TheAdityaKedia/Out-The-Door/enclosure/doorstep-back/REQUIREMENTS.md

# Requirements

Doorstep-back follows every rule in [Doorstep's REQUIREMENTS.md](../doorstep/REQUIREMENTS.md) that still applies (board lock, drum mount, USB opening, hole sizing, no supports on mating faces). Rules learned from Doorstep-back prints go below.
