TheAdityaKedia/Out-The-Door/enclosure/doorstep-back/renders/body-1.png

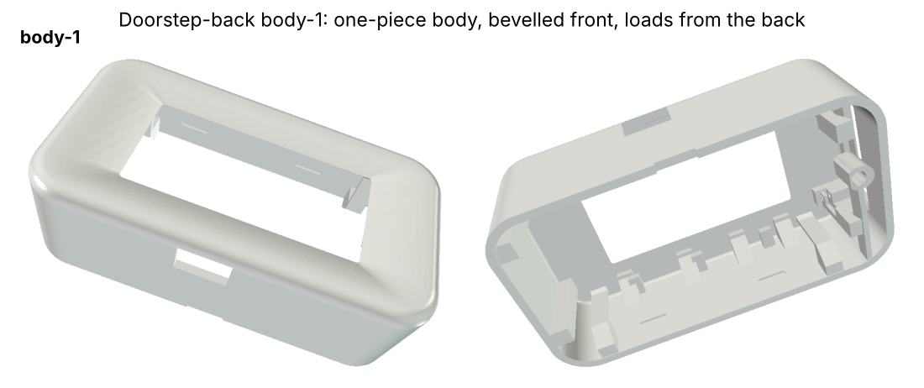
enclosure/doorstep-back/renders/body-1.png
