TheAdityaKedia/Out-The-Door/enclosure/doorstep-back/renders/cap-1.png

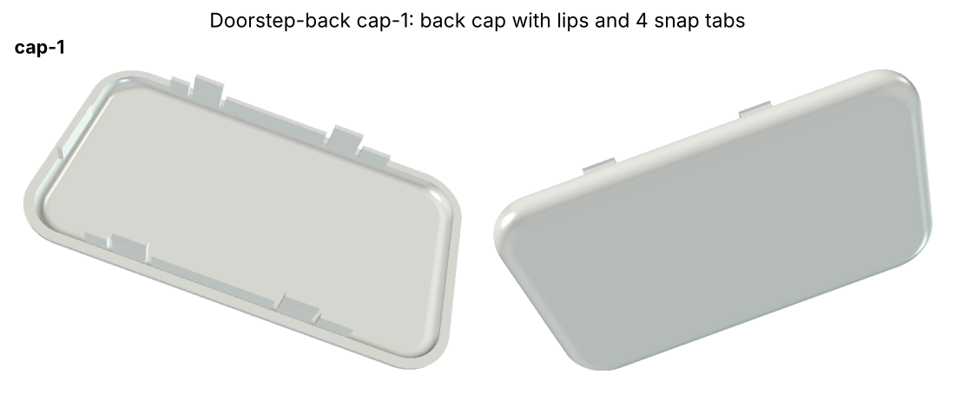
enclosure/doorstep-back/renders/cap-1.png
