TheAdityaKedia/Out-The-Door/enclosure/doorstep-back/renders/drum-1.png

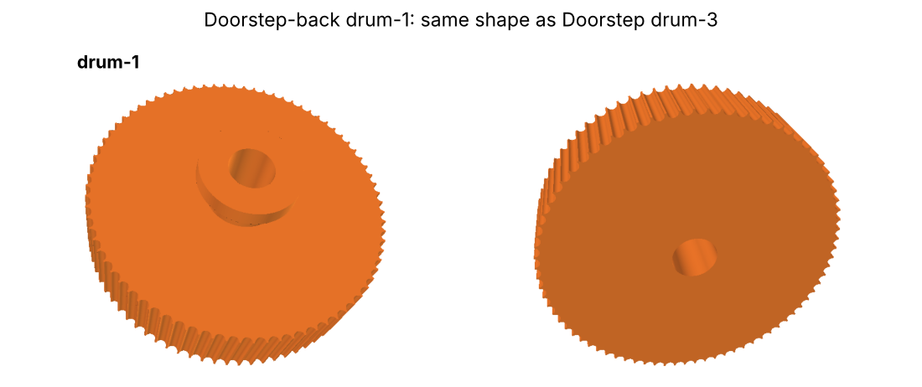
enclosure/doorstep-back/renders/drum-1.png
