TheAdityaKedia/Out-The-Door/enclosure/doorstep-back/renders/pin-1.png

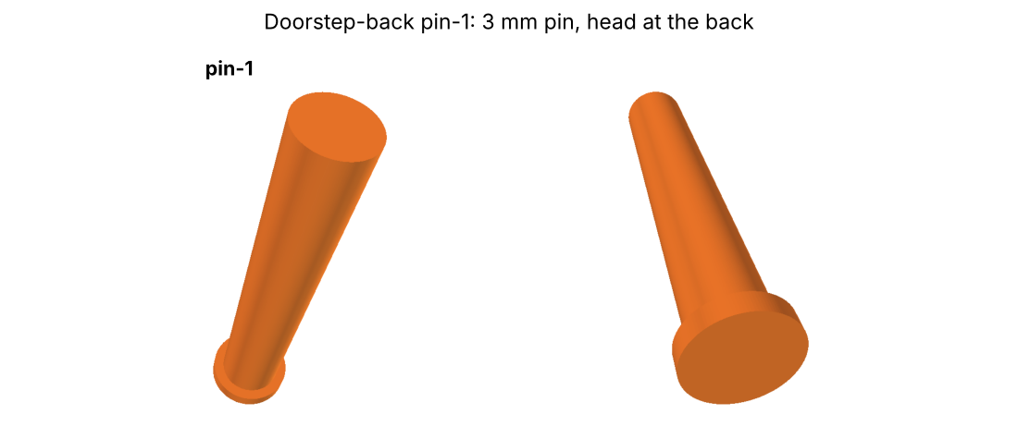
enclosure/doorstep-back/renders/pin-1.png
