TheAdityaKedia/Out-The-Door/enclosure/doorstep/docs/board_lock_preview.png

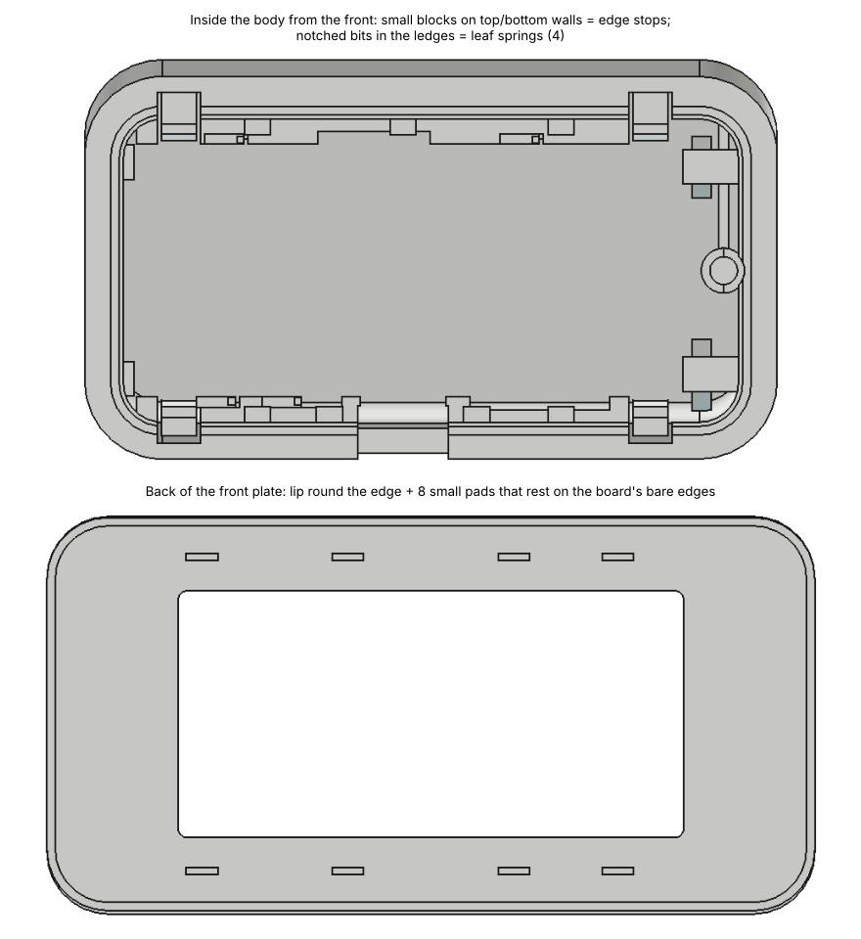
enclosure/doorstep/docs/board_lock_preview.png
