TheAdityaKedia/Out-The-Door/enclosure/doorstep/docs/board_spring_idea.png

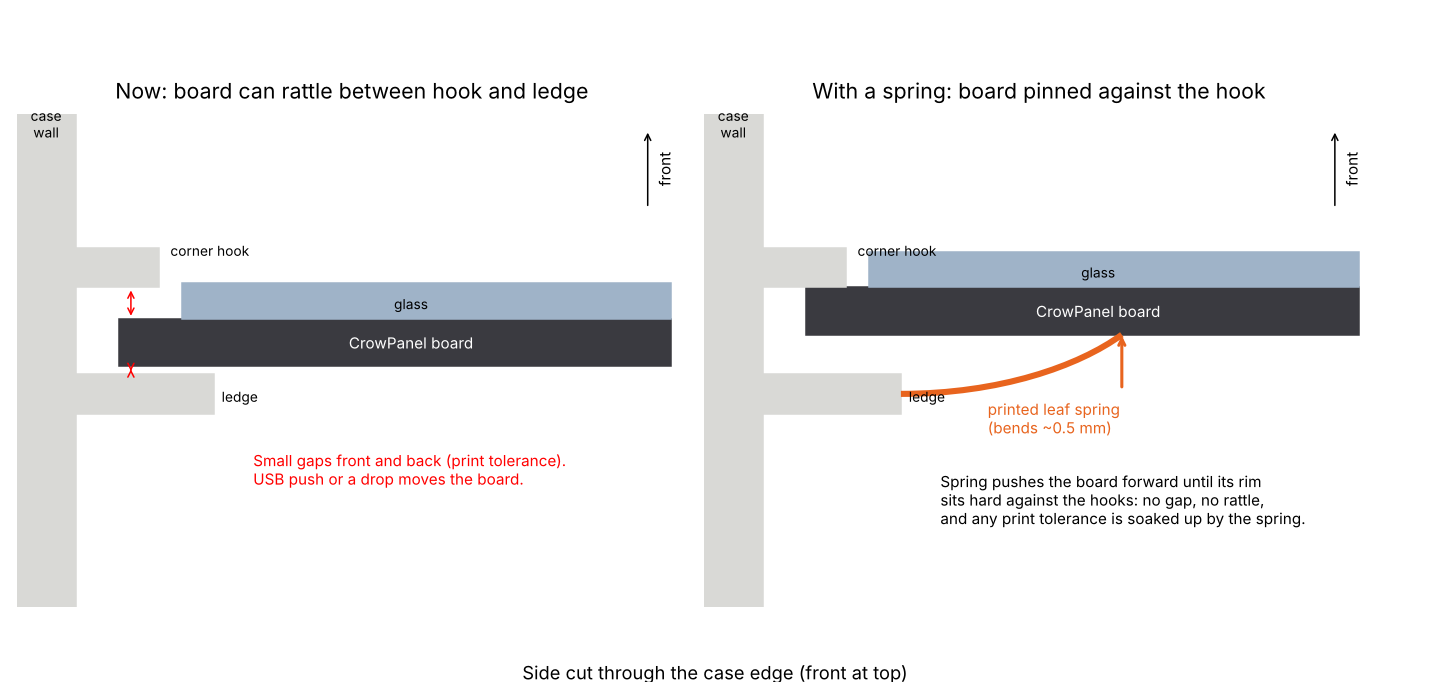
enclosure/doorstep/docs/board_spring_idea.png
