TheAdityaKedia/Out-The-Door/enclosure/doorstep/docs/drum_contact_slice.png

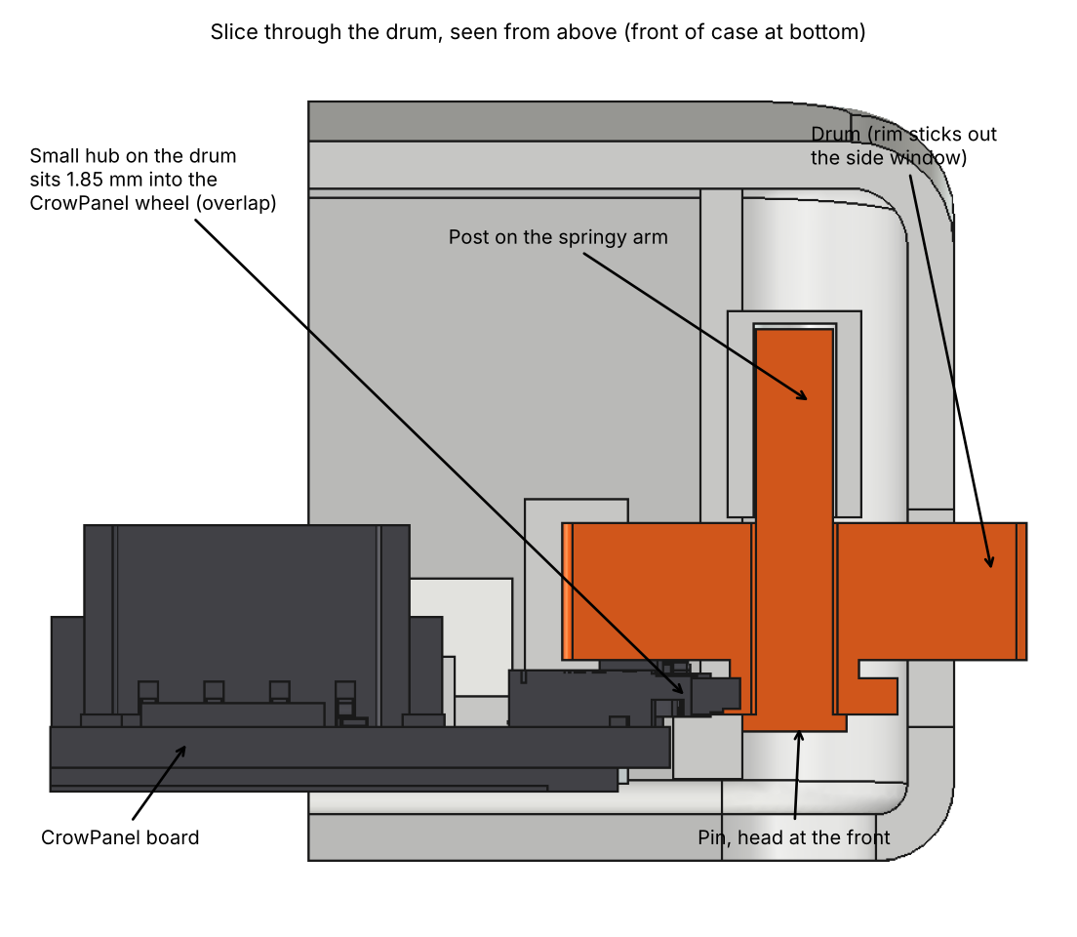
enclosure/doorstep/docs/drum_contact_slice.png
