TheAdityaKedia/Out-The-Door/enclosure/doorstep/docs/lip_buttons_preview.png

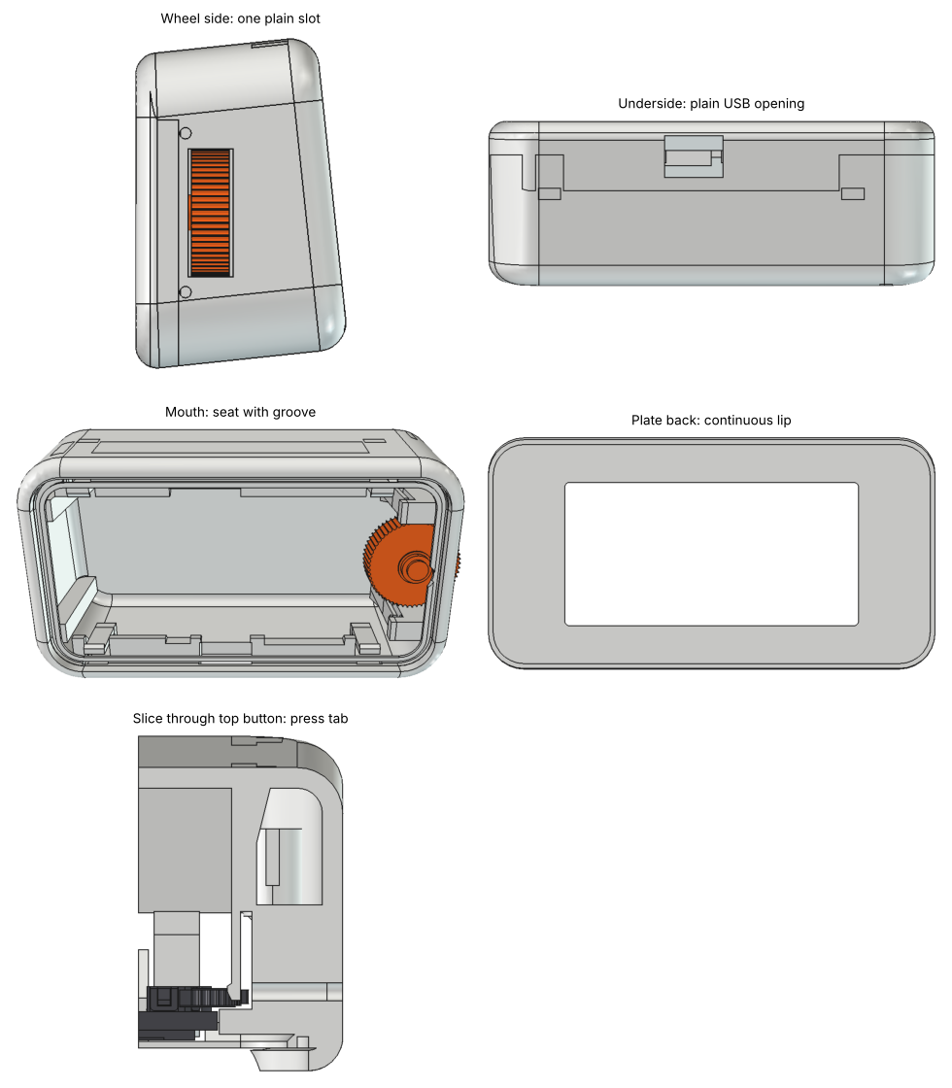
enclosure/doorstep/docs/lip_buttons_preview.png
