TheAdityaKedia/Out-The-Door/enclosure/doorstep/docs/wheel_end_no_drum.png

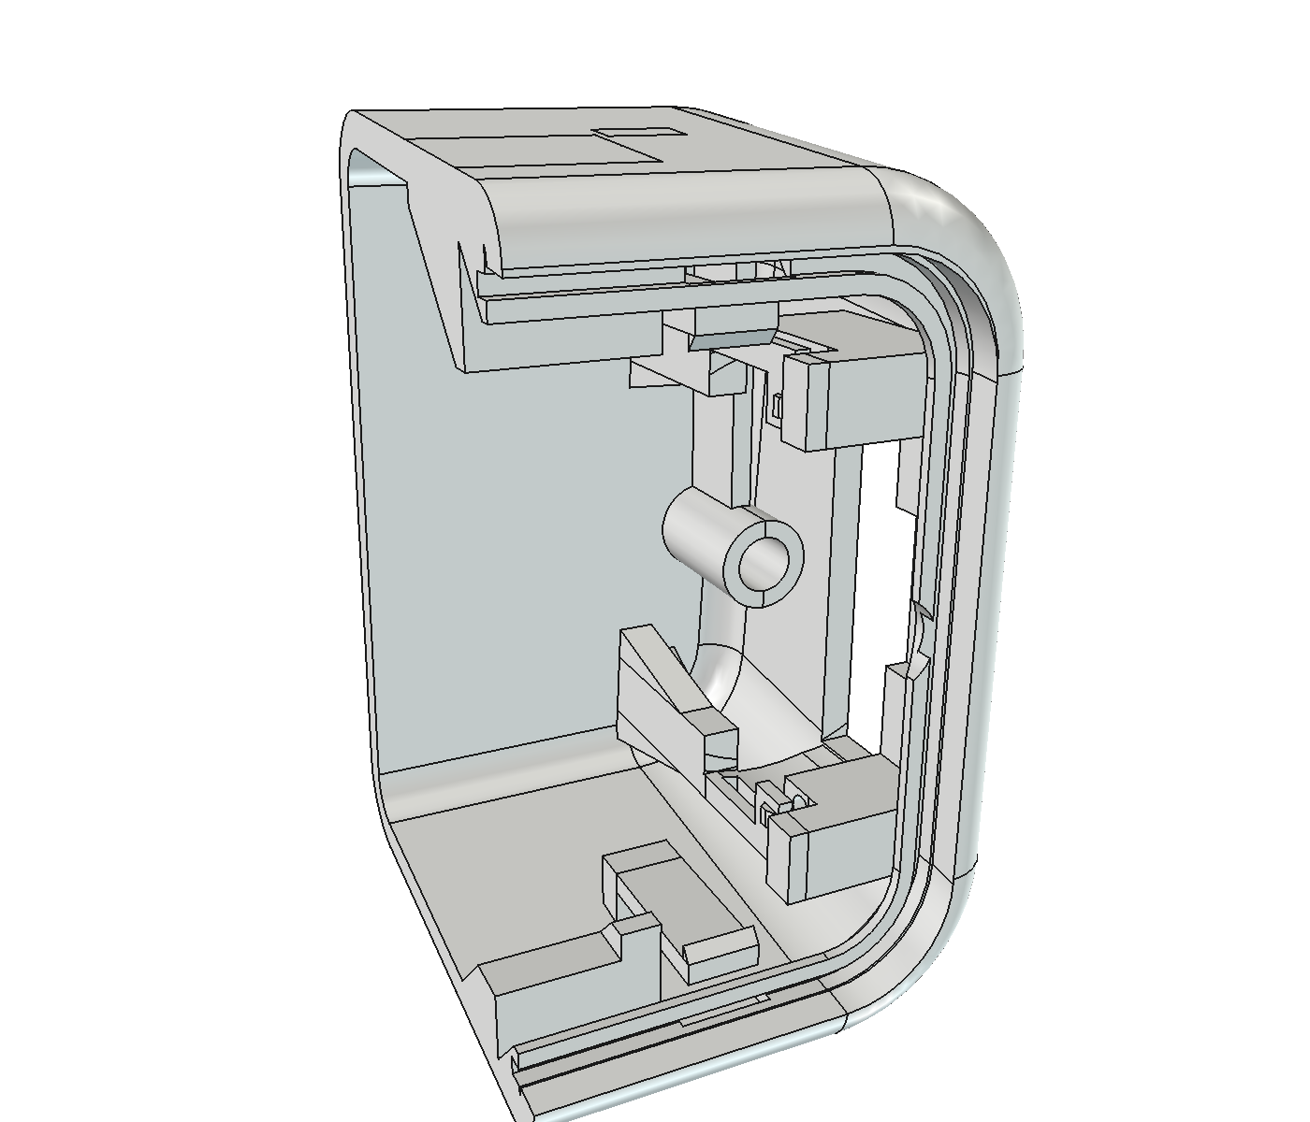
enclosure/doorstep/docs/wheel_end_no_drum.png
