TheAdityaKedia/Out-The-Door/enclosure/doorstep/renders/body-1.png

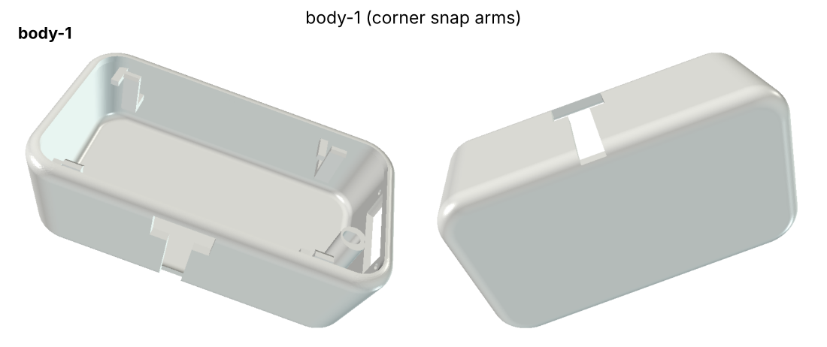
enclosure/doorstep/renders/body-1.png
