TheAdityaKedia/Out-The-Door/enclosure/doorstep/renders/body-2.png

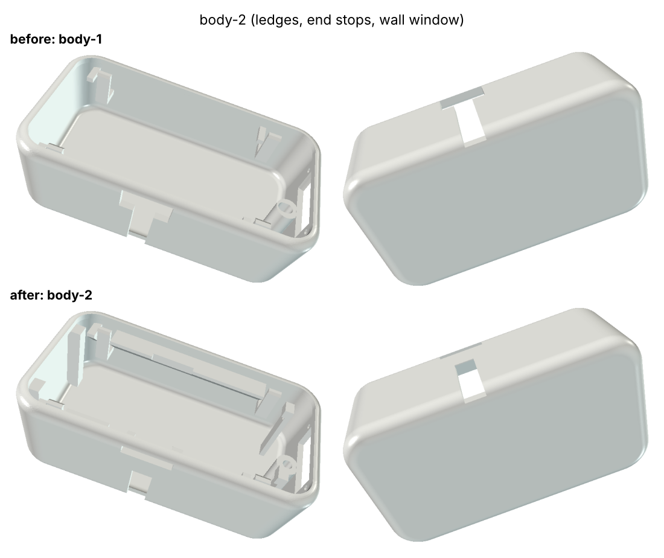
enclosure/doorstep/renders/body-2.png
