TheAdityaKedia/Out-The-Door/enclosure/doorstep/renders/body-3.png

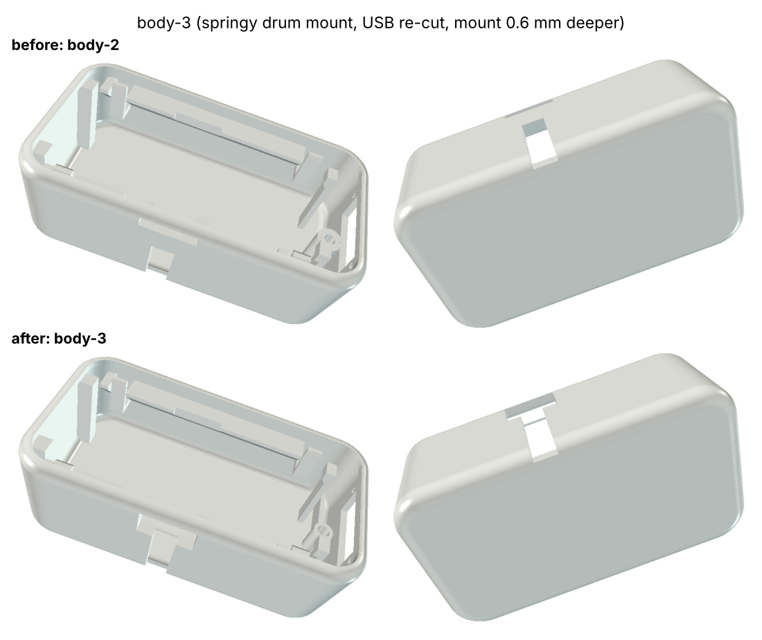
enclosure/doorstep/renders/body-3.png
