TheAdityaKedia/Out-The-Door/enclosure/doorstep/renders/drum-1.png

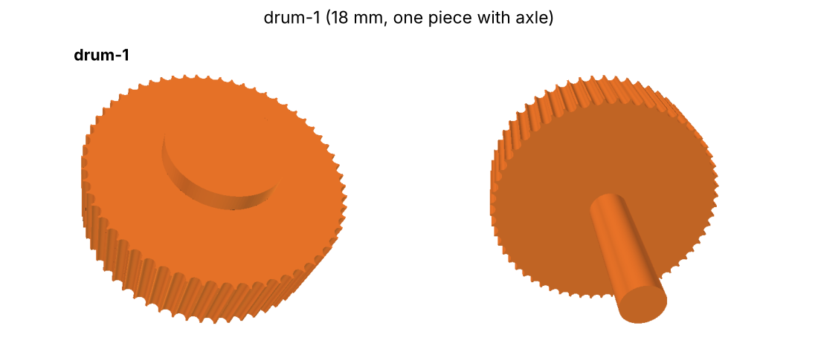
enclosure/doorstep/renders/drum-1.png
