TheAdityaKedia/Out-The-Door/enclosure/doorstep/renders/drum-2.png

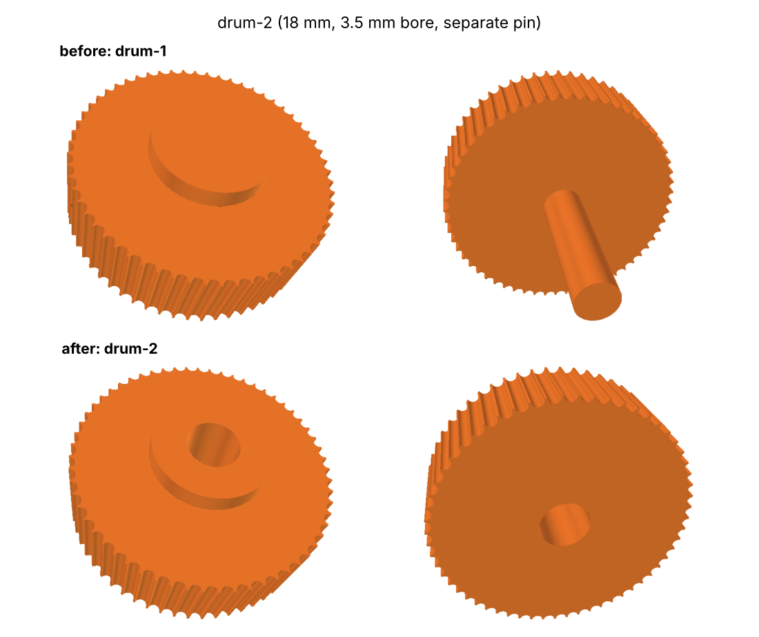
enclosure/doorstep/renders/drum-2.png
