TheAdityaKedia/Out-The-Door/enclosure/doorstep/renders/drum-3.png

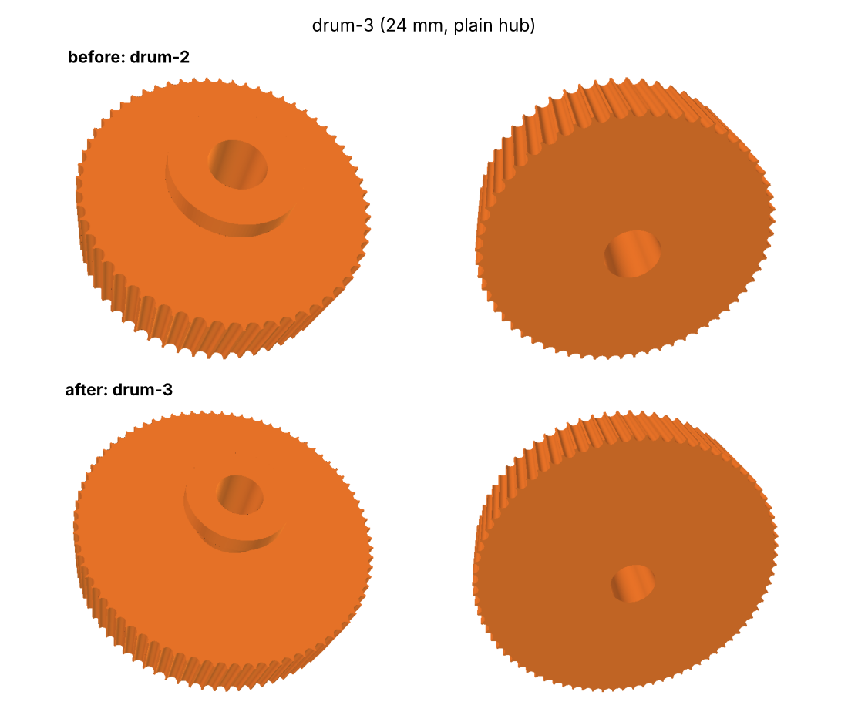
enclosure/doorstep/renders/drum-3.png
