TheAdityaKedia/Out-The-Door/enclosure/doorstep/renders/front-1.png

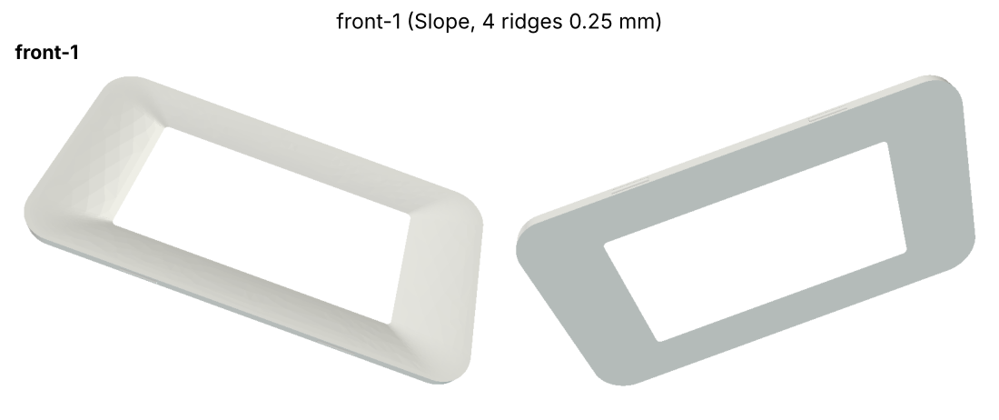
enclosure/doorstep/renders/front-1.png
