TheAdityaKedia/Out-The-Door/enclosure/doorstep/renders/front-2.png

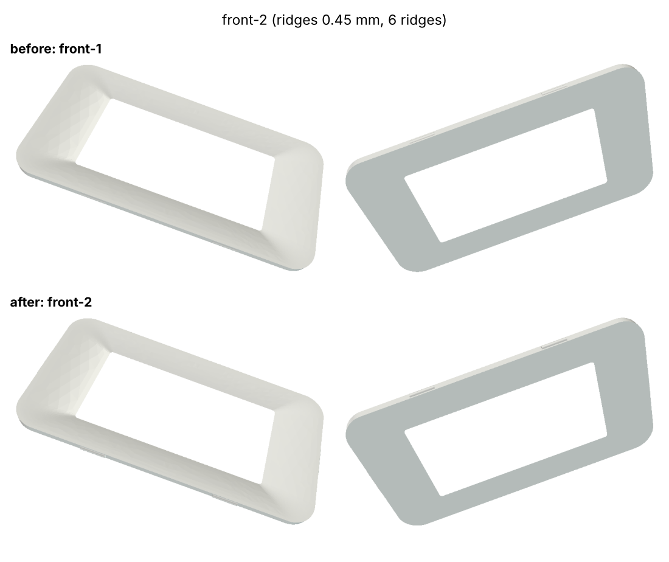
enclosure/doorstep/renders/front-2.png
