TheAdityaKedia/Out-The-Door/enclosure/doorstep/renders/pin-1.png

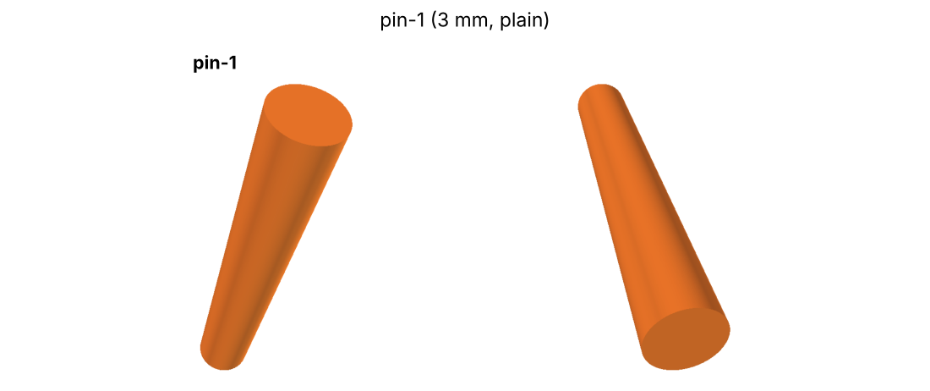
enclosure/doorstep/renders/pin-1.png
