TheAdityaKedia/Out-The-Door/enclosure/doorstep/renders/pin-2.png

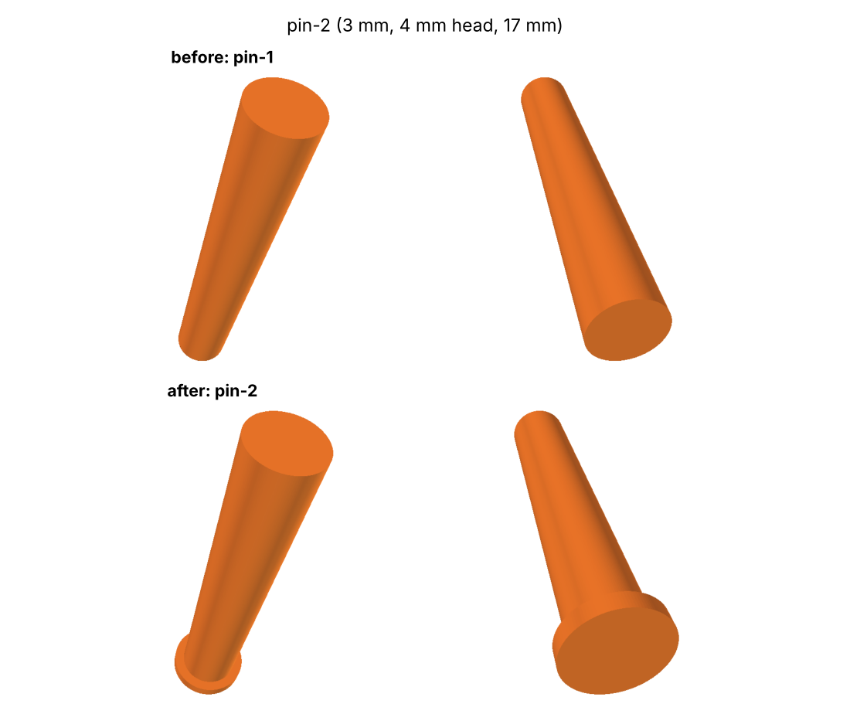
enclosure/doorstep/renders/pin-2.png
