TheAdityaKedia/Out-The-Door/previews/1_trains.png

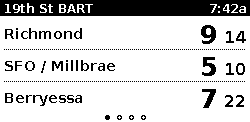
previews/1_trains.png
