TheAdityaKedia/Out-The-Door/previews/1_trains_4x.png

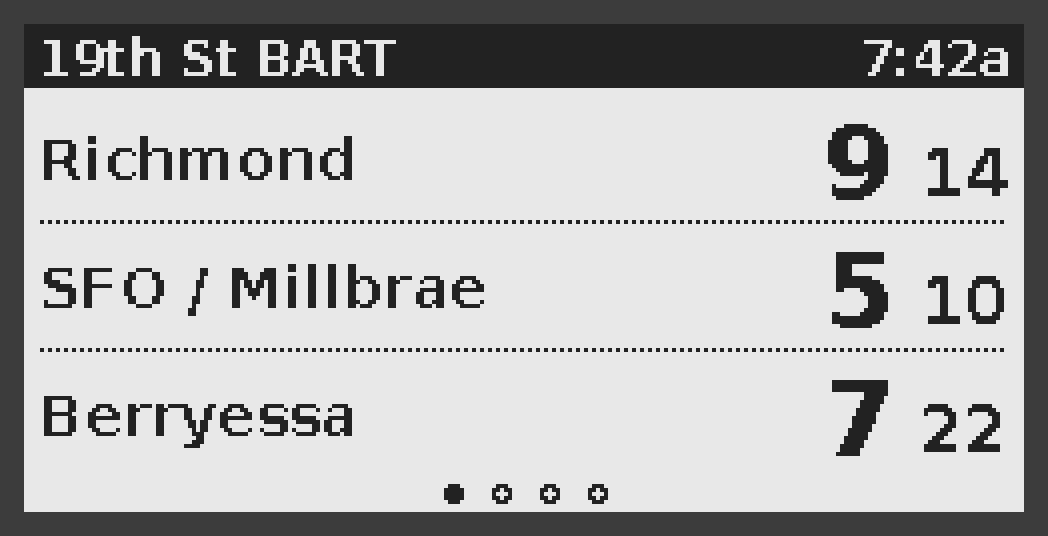
previews/1_trains_4x.png
