TheAdityaKedia/Out-The-Door/previews/2_weather.png

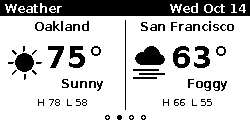
previews/2_weather.png
