TheAdityaKedia/Out-The-Door/previews/2_weather_4x.png

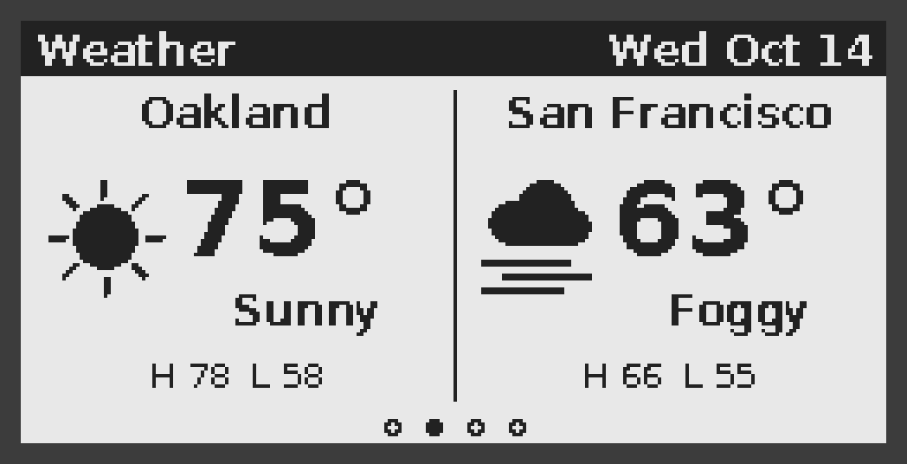
previews/2_weather_4x.png
