TheAdityaKedia/Out-The-Door/previews/3_oblique.png

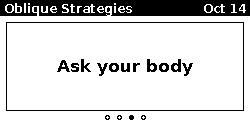
previews/3_oblique.png
