TheAdityaKedia/Out-The-Door/previews/3_oblique_4x.png

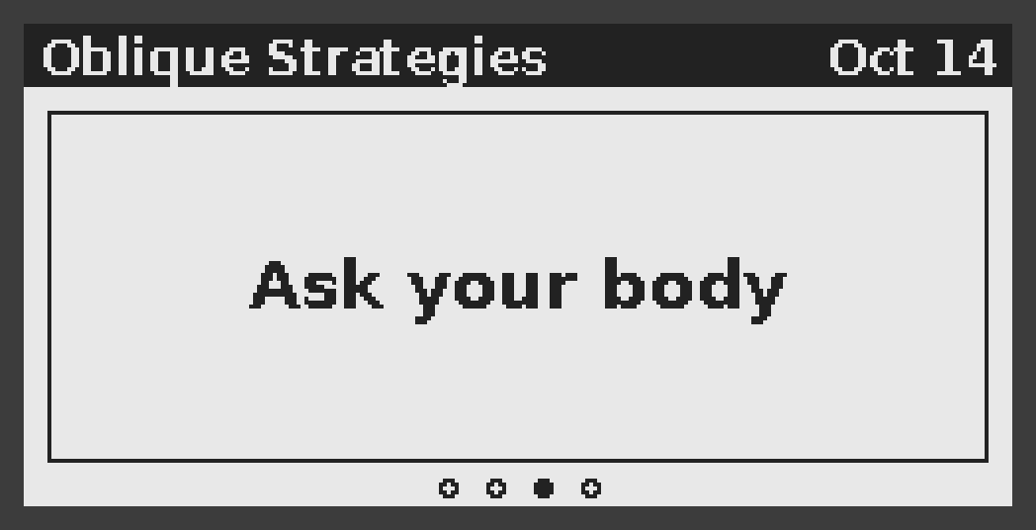
previews/3_oblique_4x.png
