TheAdityaKedia/Out-The-Door/previews/4_moon.png

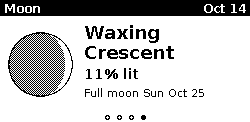
previews/4_moon.png
