TheAdityaKedia/Out-The-Door/previews/4_moon_4x.png

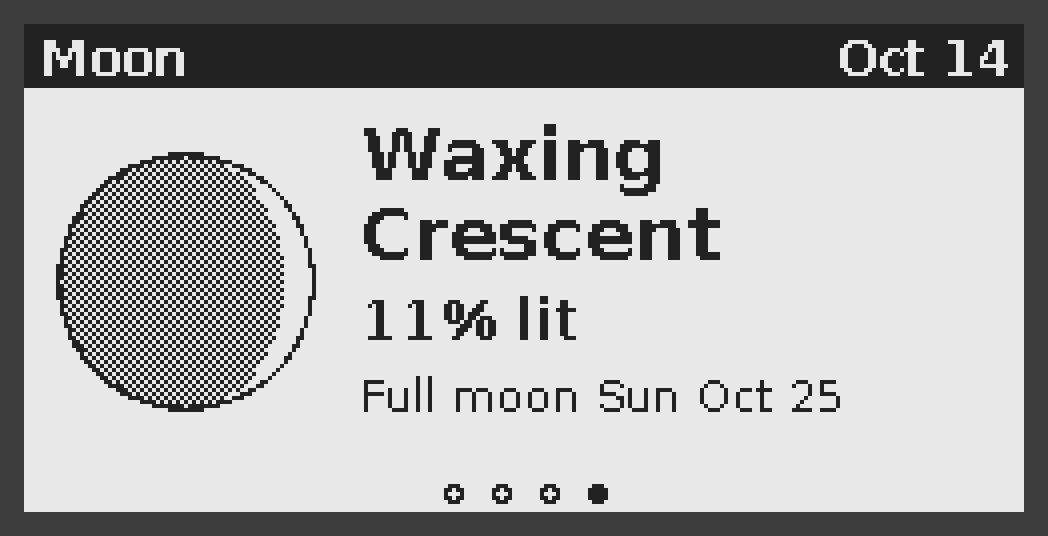
previews/4_moon_4x.png
