TheAdityaKedia/Out-The-Door/previews/5_trains_stale.png

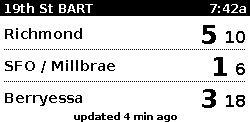
previews/5_trains_stale.png
