TheAdityaKedia/Out-The-Door/previews/6_trains_none.png

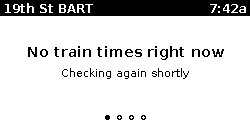
previews/6_trains_none.png
