TheAdityaKedia/Out-The-Door/previews/6_trains_none_4x.png

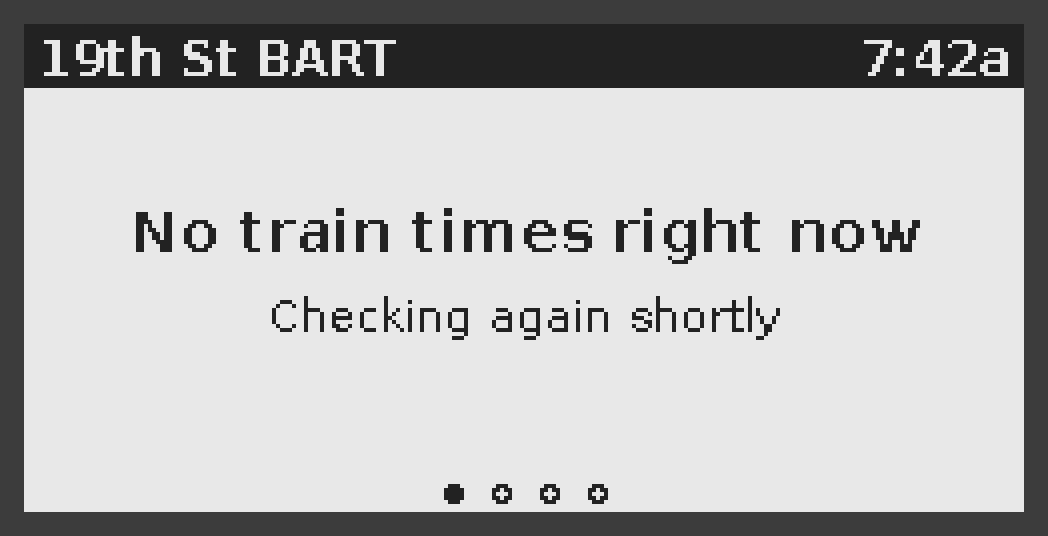
previews/6_trains_none_4x.png
