TheAdityaKedia/Out-The-Door/previews/7_oblique_long.png

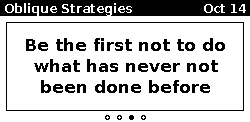
previews/7_oblique_long.png
