TheAdityaKedia/Out-The-Door/previews/7_oblique_long_4x.png

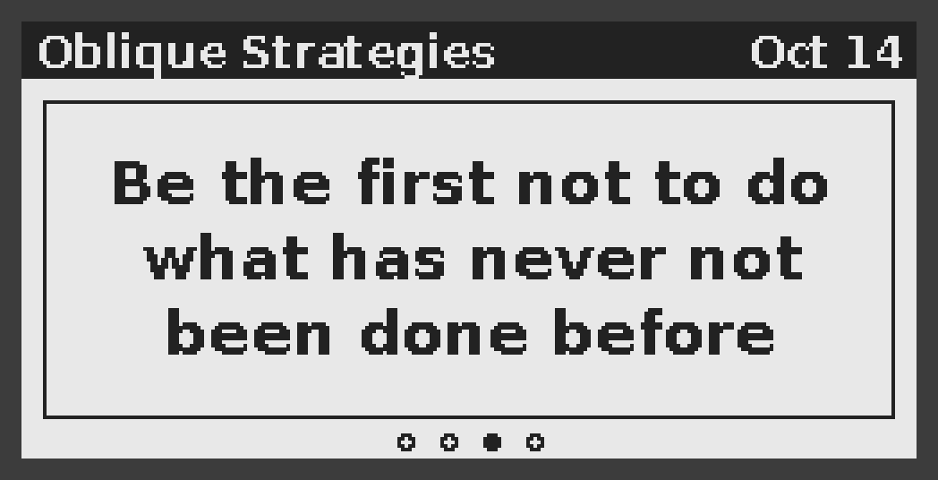
previews/7_oblique_long_4x.png
