TheAdityaKedia/Out-The-Door/enclosure/doorstep-back/parts.md

# Part revisions

Same rules as [Doorstep](../doorstep/parts.md): each part has its own number, bumped only when its STL changes, one `stl: <part>-<n> (...)` commit per revision. Doorstep-back numbers are separate from Doorstep's.

| Part | File |
|---|---|
| body | `print-ready/doorstep_back_body_white.stl` |
| cap | `print-ready/doorstep_back_cap_white.stl` |
| drum | `print-ready/latch_drum_orange.stl` |
| pin | `print-ready/latch_pin_orange.stl` |

| Revision | Commit | Model commit | What changed | Printed in | Render |
|---|---|---|---|---|---|
| body-1 | `9c93126` | `5a48217` | One piece with a bevelled front; board loads from the back onto front pads, 4 snap arms | | [png](renders/body-1.png) |
| cap-1 | `3d4ff56` | `5a48217` | Full back cap, locating lips, 4 snap tabs | | [png](renders/cap-1.png) |
| drum-1 | `3235b1d` | `5a48217` | 24 mm, plain hub (same shape as Doorstep drum-3) | | [png](renders/drum-1.png) |
| pin-1 | `9a605a8` | `5a48217` | 3 mm, 4 mm head at the back, goes in from behind | | [png](renders/pin-1.png) |
