TheAdityaKedia/Out-The-Door/enclosure/doorstep-back/models/back_cap.step

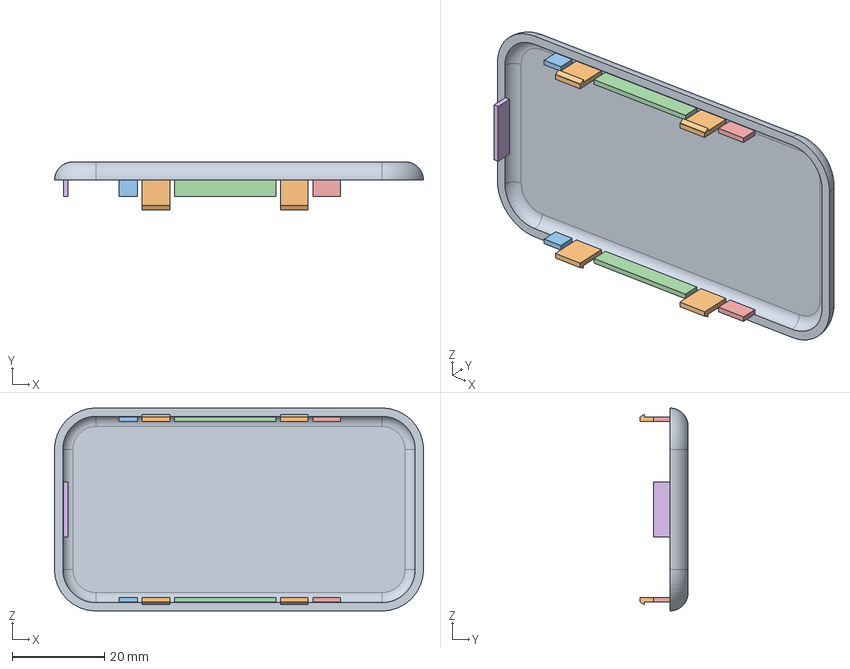
[picture p35: CAD file, 2026-11-12]
enclosure/doorstep-back/models/back_cap.step
80.0 x 10.5 x 44.0 mm
