TheAdityaKedia/Out-The-Door/enclosure/doorstep-back/print-ready/doorstep_back_bed.3mf

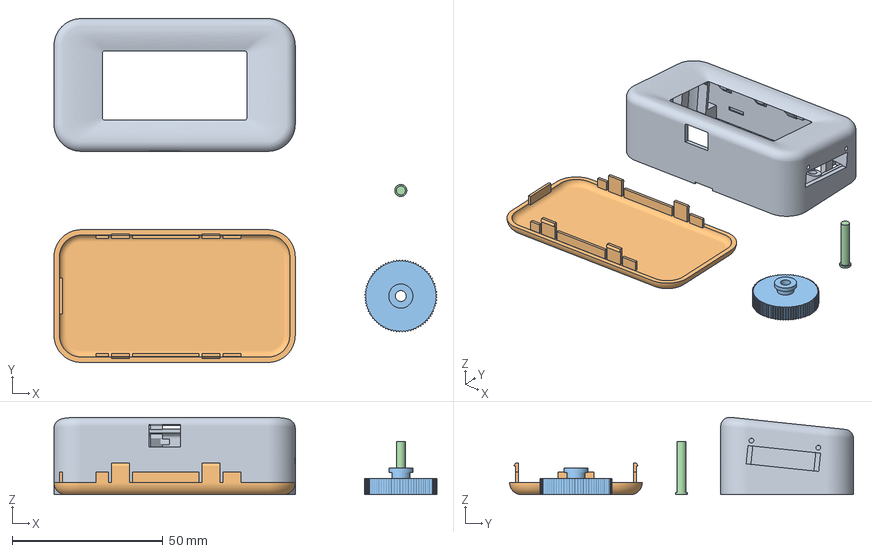
[picture p36: CAD file, 2026-11-12]
enclosure/doorstep-back/print-ready/doorstep_back_bed.3mf
127.0 x 114.0 x 25.7 mm
doorstep_back_body_white
doorstep_back_cap_white
latch_drum_orange
latch_pin_orange
