TheAdityaKedia/Out-The-Door/enclosure/doorstep/models/body.step

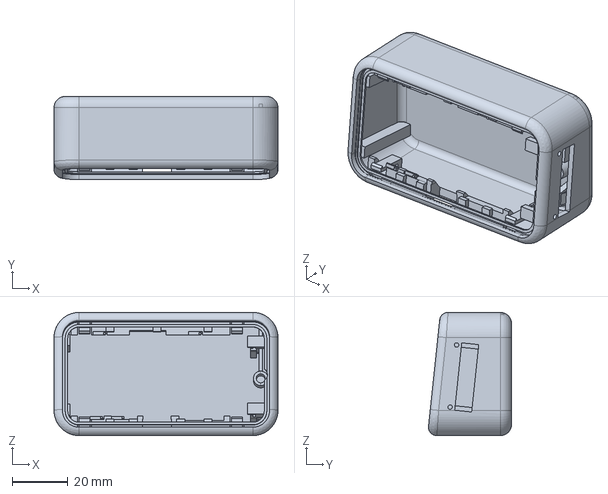
[picture p37: CAD file, 2026-11-10]
enclosure/doorstep/models/body.step
80.0 x 29.7 x 44.0 mm
