TheAdityaKedia/Out-The-Door/enclosure/doorstep/print-ready/doorstep_slope_plate.3mf

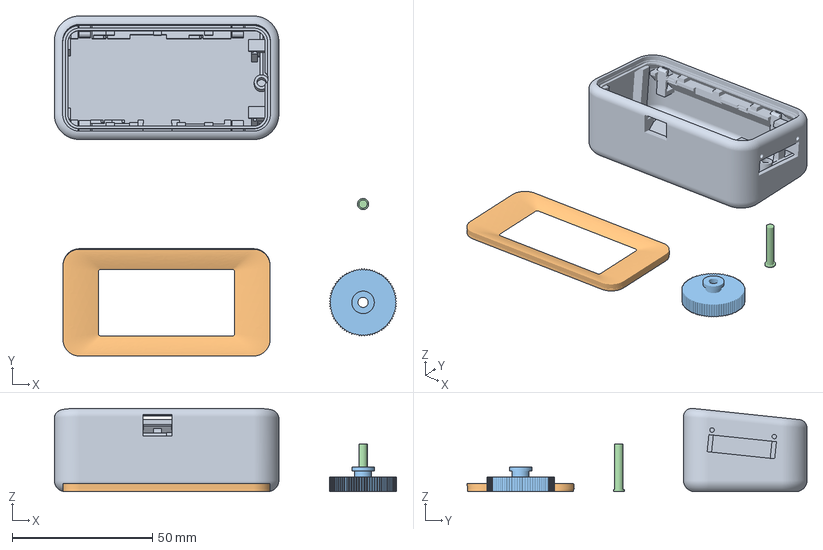
[picture p38: CAD file, 2026-11-10]
enclosure/doorstep/print-ready/doorstep_slope_plate.3mf
122.0 x 121.1 x 29.7 mm
doorstep_body_white
doorstep_slope_front_white
latch_drum_orange
latch_pin_orange
