TheAdityaKedia/Out-The-Door/enclosure/doorstep-back/models/body.step

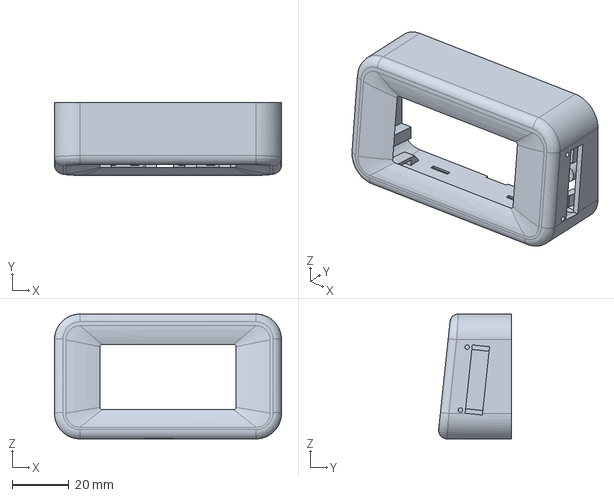
[picture p39: CAD file, 2026-11-12]
enclosure/doorstep-back/models/body.step
80.0 x 25.7 x 44.0 mm
