TheAdityaKedia/Out-The-Door/enclosure/doorstep-back/print-ready/latch_drum_orange.stl

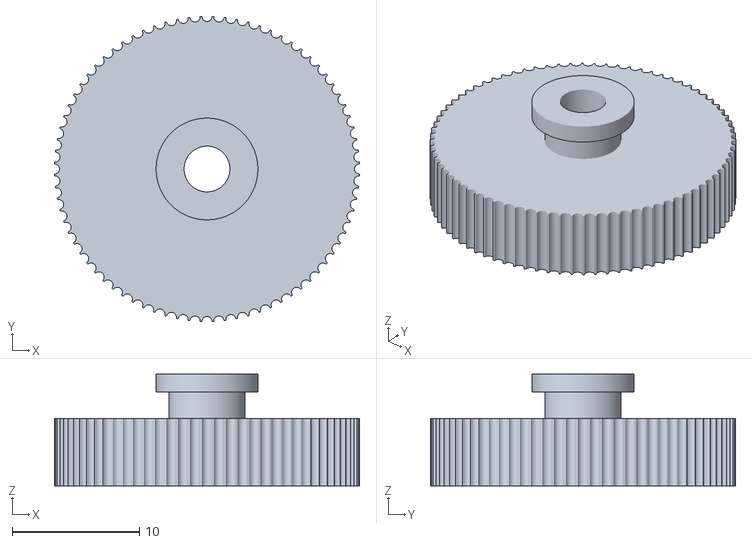
[picture p40: CAD file, 2026-11-12]
enclosure/doorstep-back/print-ready/latch_drum_orange.stl
24.0 x 24.0 x 8.80
