TheAdityaKedia/Out-The-Door/enclosure/doorstep/models/front_bevel.step

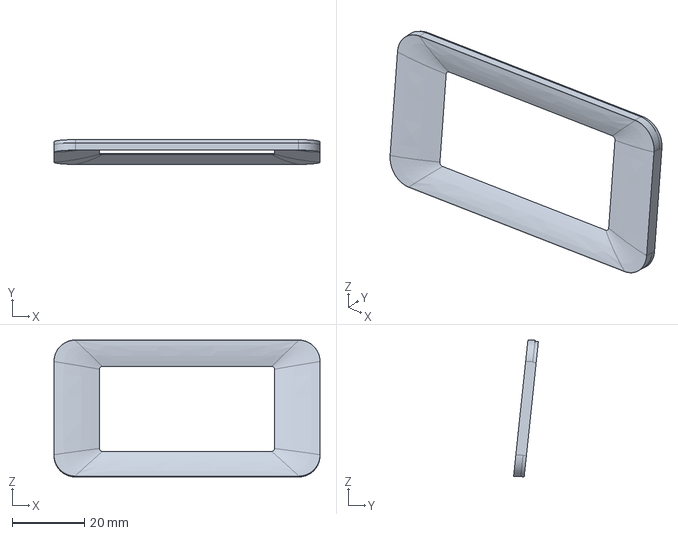
[picture p41: CAD file, 2026-11-10]
enclosure/doorstep/models/front_bevel.step
73.8 x 6.90 x 38.0 mm
