TheAdityaKedia/Out-The-Door/enclosure/doorstep-back/models/drum.step

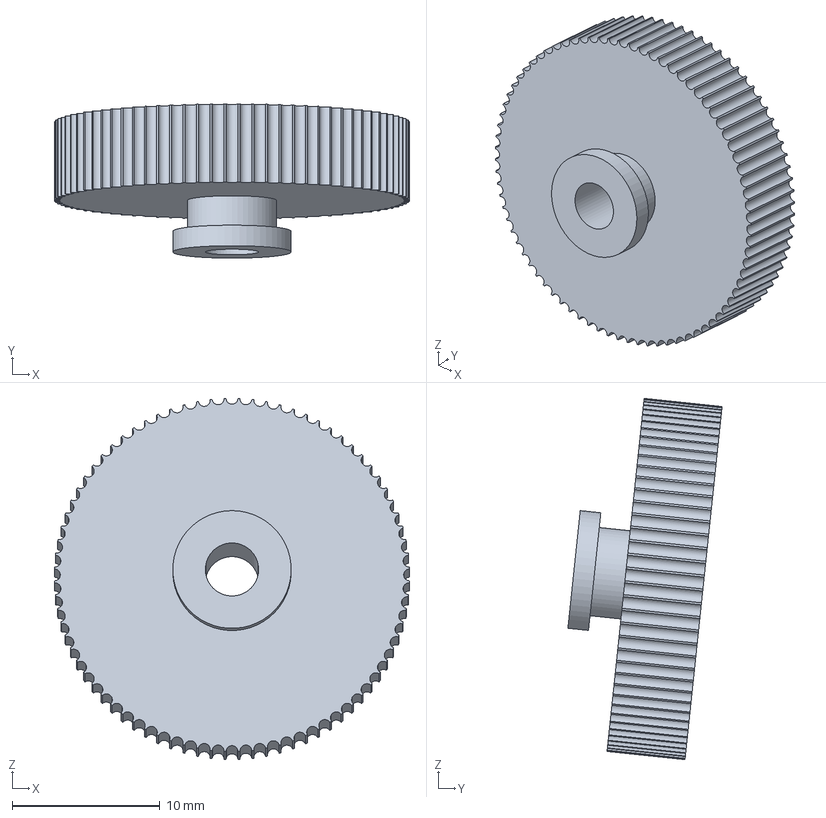
[picture p42: CAD file, 2026-11-12]
enclosure/doorstep-back/models/drum.step
24.0 x 10.4 x 24.4 mm
