TheAdityaKedia/Out-The-Door/enclosure/doorstep-back/print-ready/latch_pin_orange.stl

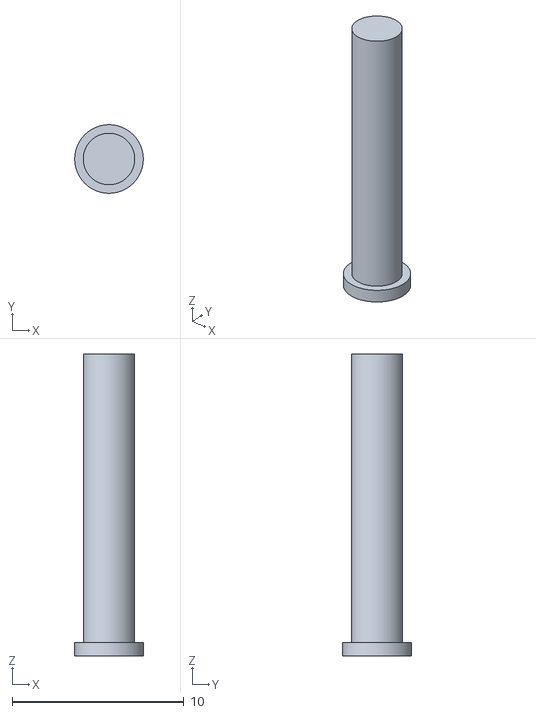
[picture p43: CAD file, 2026-11-12]
enclosure/doorstep-back/print-ready/latch_pin_orange.stl
4.00 x 4.00 x 17.6
