TheAdityaKedia/Out-The-Door/enclosure/doorstep/models/front_lens.step

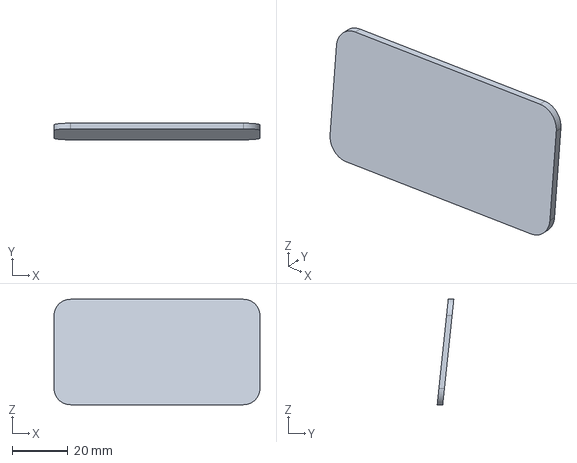
[picture p44: CAD file, 2026-11-10]
enclosure/doorstep/models/front_lens.step
73.8 x 5.98 x 37.8 mm
