TheAdityaKedia/Out-The-Door/enclosure/doorstep/print-ready/doorstep_slope_front_white.stl

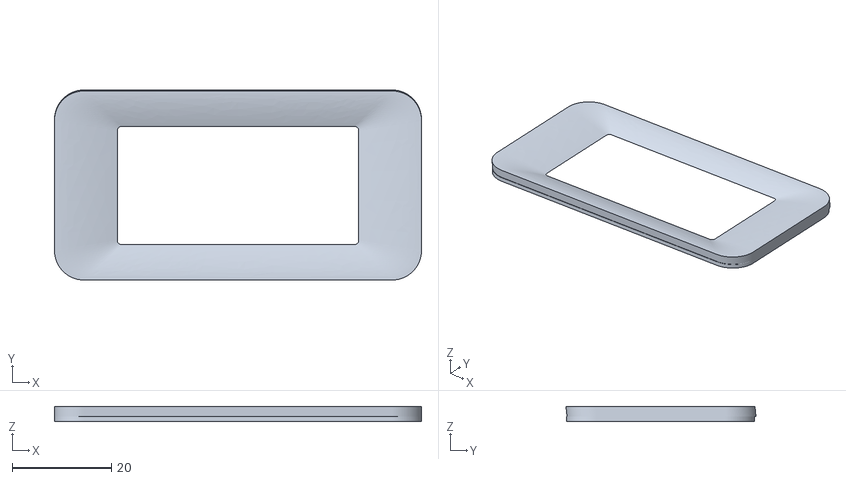
[picture p45: CAD file, 2026-11-10]
enclosure/doorstep/print-ready/doorstep_slope_front_white.stl
73.8 x 38.2 x 2.95
