TheAdityaKedia/Out-The-Door/enclosure/doorstep-back/models/pin.step

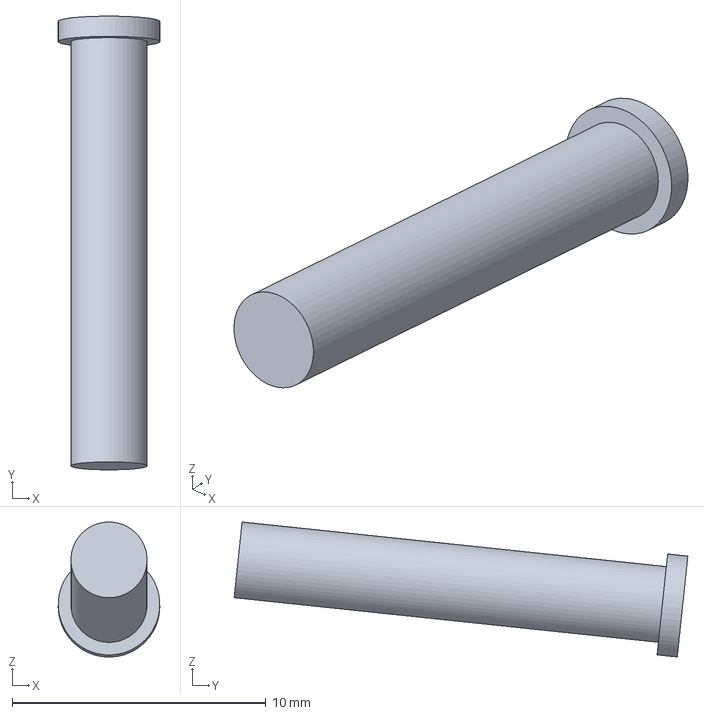
[picture p46: CAD file, 2026-11-12]
enclosure/doorstep-back/models/pin.step
4.00 x 17.9 x 5.32 mm
