TheAdityaKedia/Out-The-Door/enclosure/doorstep-back/print-ready/doorstep_back_cap_white.stl

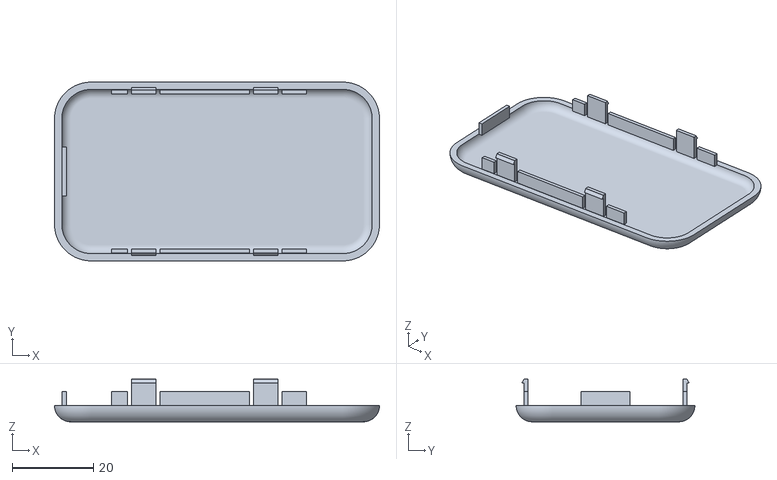
[picture p47: CAD file, 2026-11-12]
enclosure/doorstep-back/print-ready/doorstep_back_cap_white.stl
80.0 x 44.0 x 10.5
