TheAdityaKedia/Out-The-Door/enclosure/doorstep/models/latch_pin.step

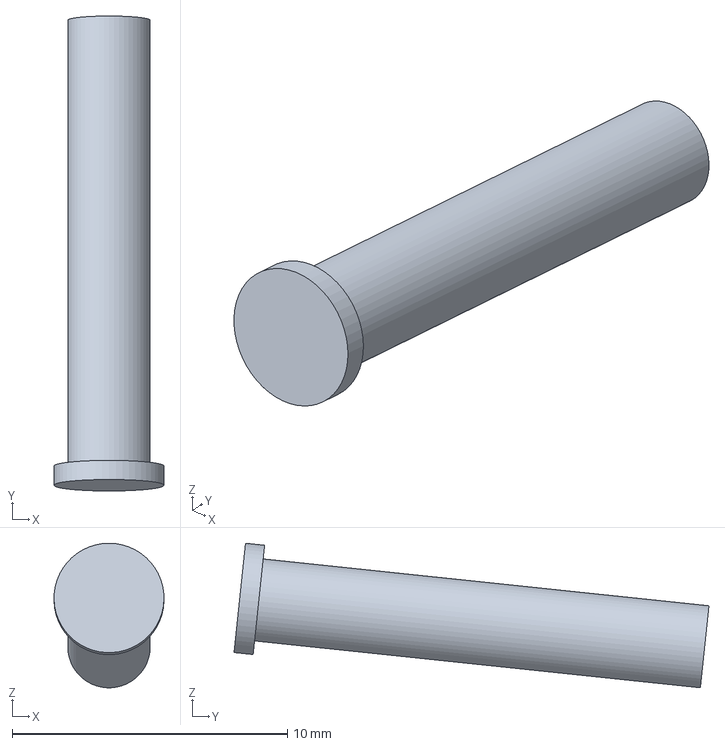
[picture p48: CAD file, 2026-11-10]
enclosure/doorstep/models/latch_pin.step
4.00 x 17.3 x 5.25 mm
