TheAdityaKedia/Out-The-Door/enclosure/doorstep/print-ready/latch_pin_orange.stl

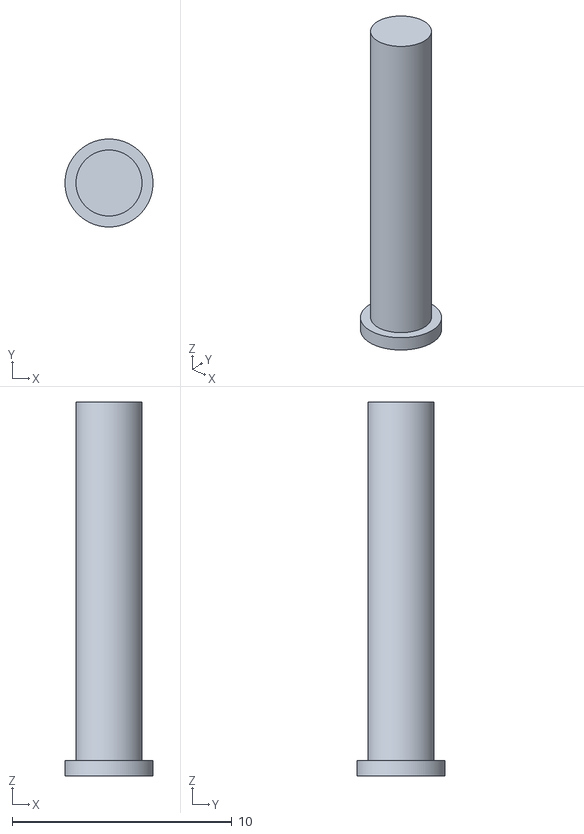
[picture p49: CAD file, 2026-11-10]
enclosure/doorstep/print-ready/latch_pin_orange.stl
4.00 x 4.00 x 17.0
