TheAdityaKedia/Out-The-Door/(list of files, cad)

Other CAD files:
enclosure/doorstep/print-ready/latch_drum_orange.stl
enclosure/doorstep/models/orange_wheel_cap.step
enclosure/doorstep/print-ready/doorstep_body_white.stl
enclosure/doorstep-back/print-ready/doorstep_back_body_white.stl
