TheAdityaKedia/Out-The-Door/enclosure/doorstep-back/assemblies/README.md

# Assembly log
One file per build (A1, A2, ...): parts used and all feedback. See [../../DEVELOPMENT.md](../../DEVELOPMENT.md).

| Build | Parts | Verdict |
|---|---|---|
