TheAdityaKedia/Out-The-Door/enclosure/doorstep-back/prints/README.md

# Print log
One file per print (P1, P2, ...): only what was printed and with what settings. See [../../DEVELOPMENT.md](../../DEVELOPMENT.md).

| Print | Date | Parts |
|---|---|---|
