TheAdityaKedia/Out-The-Door/enclosure/doorstep/assemblies/README.md

# Assembly log
One file per build (A1, A2, ...): which part revisions went in and from which prints, plus all feedback: how each part printed, how it fits and works, photos and videos.

| Build | Parts | Verdict |
|---|---|---|
| [A1](A01.md) | body-1, front-1, drum-1 (P1) | Board fell in; drum can't be assembled |
| [A2](A02.md) | body-2, front-2, drum-2, pin-1 (P2) | USB blocked, front bowed, drum missed wheel |
| [A3](A03.md) | body-3 (P3) + drum-2, pin-1 (P2) + front-2 | Best so far: clicky drum; front lifts, drop pops it apart |
| [A4](A04.md) | body-4, front-4, drum-3, pin-2 (P5) | Board solid; front proud; drum only drives when pressed; buttons can't be pressed |
| [A5](A05.md) | body-4, drum-3, pin-2 (P5) + front-2 (P3) | Old flat-backed front fits well; window looks better |
