TheAdityaKedia/Out-The-Door/enclosure/doorstep/prints/README.md

# Print log
One file per print (P1, P2, ...): only what was printed and with what settings. How it came out and how it worked go in the [assembly log](../assemblies/README.md). Part revisions: [../parts.md](../parts.md).

| Print | Date | Parts |
|---|---|---|
| [P1](P01.md) | 11-05/06 | body-1, front-1, drum-1 |
| [P2](P02.md) | 11-09 | body-2, front-2, drum-2, pin-1 |
| [P3](P03.md) | 11-09 | body-3, front-2 |
| [P4](P04.md) | 11-09 | front-3 (abandoned) |
| [P5](P05.md) | 11-09 night | body-4, front-4, drum-3, pin-2 |
