TheAdityaKedia/Out-The-Door/enclosure/doorstep/assemblies/A03.md

# A3: body-3 (P3) + drum-2 + pin-1 (P2) + front-2 (P3)
- Very satisfying so far. The springy arm makes the plain drum-2 catch the wheel and turn it with clear, tactile clicks. Keep this feel.
- Some tension between pressing and turning the drum.
- Front plate: the ridges lifted it at the bottom; seams uneven.
- Button pillars weak; pressing a button meant threading a needle through two holes; wheel window too wide.
- Drop test: front plate and panel popped out. Panel gives when plugging in USB.
- Up-down and slight side-to-side board wiggle.
