TheAdityaKedia/Out-The-Door/enclosure/doorstep/prints/P01.md

# P1 (2026-11-05 or 06, Pacific)
Model commit `d515d98`. Bambu X2D, AMS white + orange.

| Part | Revision | Colour | Settings |
|---|---|---|---|
| body | body-1 | white | not recorded |
| front | front-1 | white | not recorded |
| drum | drum-1 | orange | not recorded |

How it went: [A1](../assemblies/A01.md).
