TheAdityaKedia/Out-The-Door/enclosure/doorstep/prints/P02.md

# P2 (2026-11-09, Pacific)
Model commit `f99f9fc`.

| Part | Revision | Colour | Settings |
|---|---|---|---|
| body | body-2 | white | not recorded |
| front | front-2 | white | not recorded |
| drum | drum-2 | orange | not recorded |
| pin | pin-1 | orange | not recorded |

How it went: [A2](../assemblies/A02.md); drum and pin reused in [A3](../assemblies/A03.md).
