TheAdityaKedia/Out-The-Door/enclosure/doorstep/prints/P03.md

# P3 (2026-11-09, Pacific)
Model commit `d340d7d`.

| Part | Revision | Colour | Settings |
|---|---|---|---|
| body | body-3 | white | not recorded |
| front | front-2 | white | not recorded |

How it went: [A3](../assemblies/A03.md); front reused in [A5](../assemblies/A05.md).
