TheAdityaKedia/Out-The-Door/enclosure/doorstep/prints/P04.md

# P4 (2026-11-09, Pacific): abandoned
Model commit `23641a8`.

| Part | Revision | Colour | Settings |
|---|---|---|---|
| front | front-3 | white | tree supports |
| others on the plate | not recorded | | |

Stopped partway: the pads on the plate's back printed as tiny islands and ruined it. Not assembled.
