TheAdityaKedia/Out-The-Door/enclosure/doorstep/prints/P05.md

# P5 (2026-11-09 overnight, Pacific)
Model commit `1c2e20c`.

| Part | Revision | Colour | Settings |
|---|---|---|---|
| body | body-4 | white | supports (not otherwise recorded) |
| front | front-4 | white | adaptive layer height; standing on its lip ring, supports under the back |
| drum | drum-3 | orange | not recorded (printed as `latch_drum_orange_plain.stl`) |
| pin | pin-2 | orange | not recorded |

How it went: [A4](../assemblies/A04.md) and [A5](../assemblies/A05.md).
