TheAdityaKedia/Out-The-Door/enclosure/doorstep/assemblies/A01.md

# A1: body-1 + front-1 + drum-1 (all P1)
- Board fell back into the shell: the small shelves printed as floating overhangs.
- The one-piece drum and axle could not be fitted past the wall.
- Front plate too loose (not sure).
