TheAdityaKedia/Out-The-Door/enclosure/doorstep/assemblies/A02.md

# A2: body-2 + front-2 + drum-2 + pin-1 (all P2)
- Worked: end stops; the drum goes in through the window.
- USB-C hole half filled by a gusset.
- Front bowed out with the panel in (glass only 0.1 mm behind the plate).
- Pin would not enter the post.
- Drum test: hub missed the wheel by ~0.8 mm; ~0.5 mm board side play; drum slid along the pin; pressing moved the board.
