TheAdityaKedia/Out-The-Door/enclosure/doorstep/docs/assembly_guide.png

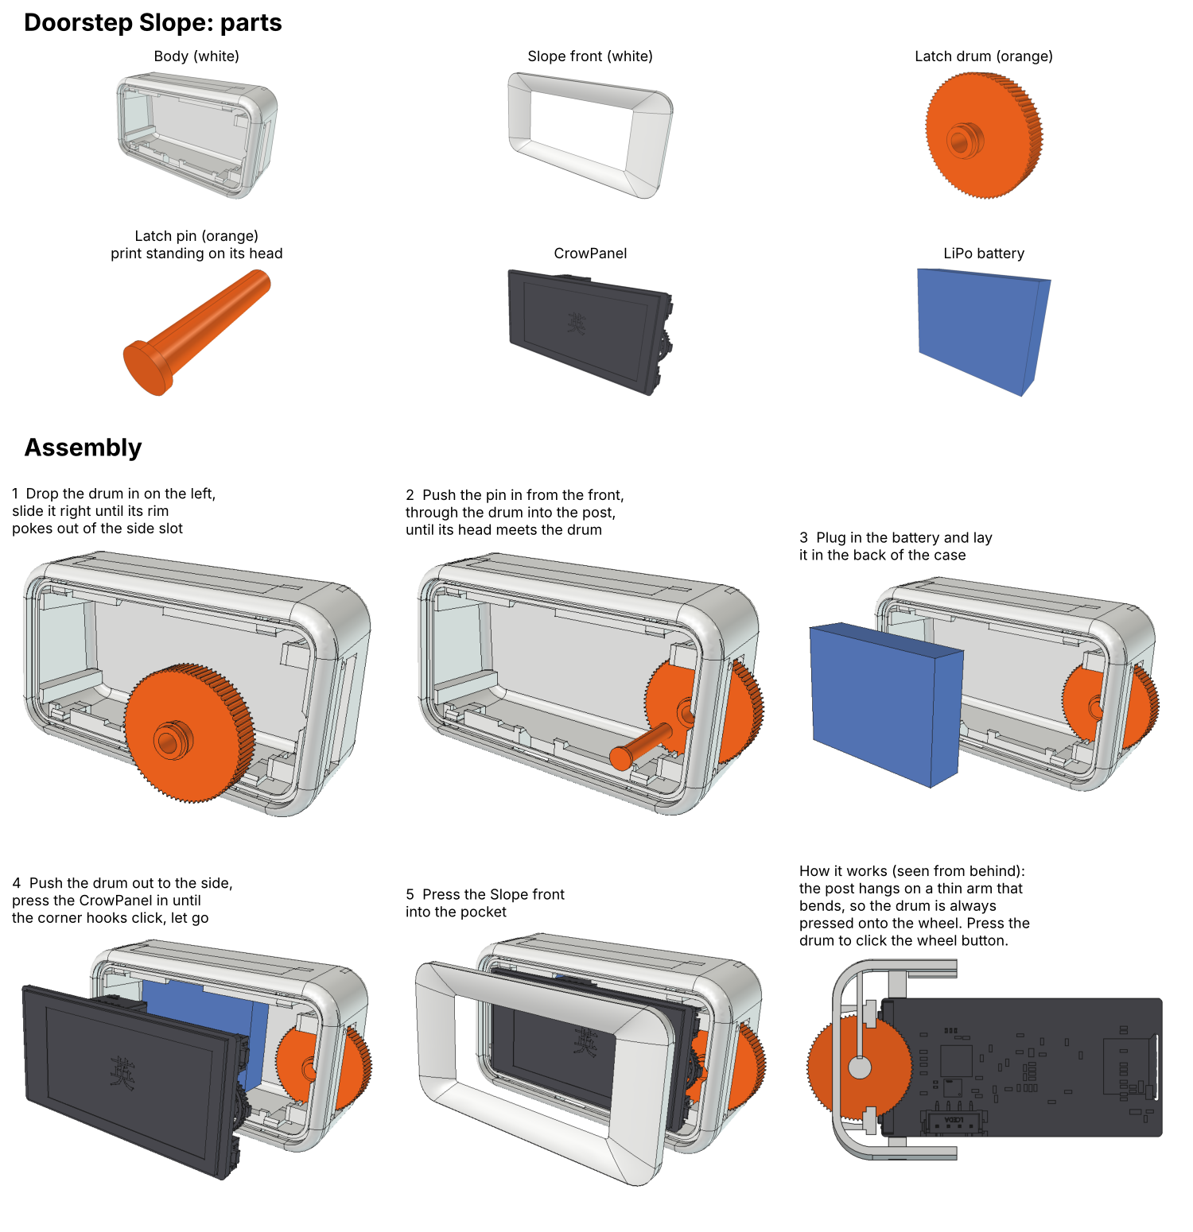
enclosure/doorstep/docs/assembly_guide.png
