TheAdityaKedia/Out-The-Door/firmware/secrets_example.py

# Copy this file to secrets.py and fill it in. secrets.py is never committed.
WIFI_SSID = "your-network"
WIFI_PASSWORD = "your-password"

# Free key from https://api.bart.gov/api/register.aspx
# (BART's shared public key works too: MW9S-E7SL-26DU-VV8V)
BART_KEY = "MW9S-E7SL-26DU-VV8V"
