TheAdityaKedia/Out-The-Door/(commit log)

2026-10-14 Track firmware/lib package marker (ignored by the Python .gitignore)
    Claude-Session: https://claude.ai/code/session_013CKN1wwP2x3DU915MD2DSc
2026-10-20 Doorstep: first clock-style case model
    74 x 44 x 30 mm one-piece white body, front leaning back 6 deg, flush
    acrylic lens, orange drum on its own axle driving the CrowPanel wheel
    rim, USB-C tunnel through the base, room for a 40 x 30 x 10 cell.
    Headless FreeCAD script with fit checks. Snapshot replayed from the
    cloud FreeCAD thread.
    Claude-Session: https://claude.ai/code/session_01AWR74AnpH4w6s2KvYrHdaw
2026-10-20 Doorstep: try a snap-on ring over the wheel (dropped)
    Experiment: a C-shaped orange ring snapping over the wheel's knurled rim,
    body centred on the board. Clashed with the MENU/BACK buttons, so the
    drum on its own axle was kept.
    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
2026-10-20 Threshold: sloped bezel, split lid and shell (retired)
    Fallback without the acrylic lens: the whole front rolls inward in one
    convex curve to a window 0.3 mm inside the active area, split into a
    front lid and back shell. Later named Threshold and retired.
    Also made the drum's axle hole blind.
    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
2026-10-22 Doorstep: one body, two fronts; board posts and front ridges
    80 mm wide body with a 2 mm front pocket that takes either a painted
    acrylic lens (Doorstep Glass) or a printed bevel insert (Doorstep
    Slope). Board sits on 2 posts and 2 ribs from the back wall and is
    clamped by the front; the bevel insert has 4 friction ridges.
    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
2026-11-06 Doorstep: corner snap arms hold the board
    4 springy arms near the board corners hook over the bare front rim,
    with small shelves under the board's back. Replaces the back-wall posts.
    This is the version of the first X2D print (2026-11-05).
    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
2026-11-09 Doorstep v2: fixes from the first print
    - Board fell back into the shell: floating shelves replaced by long
    gusseted ledges along both long walls.
    - Front too loose: ridges 0.45 mm proud (0.35 mm interference), 2 more
    on the short ends.
    - End-stop ribs at both short edges; far end split to clear the panel
    flat cable.
    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
2026-11-10 Doorstep: drum on a separate pin, passed in through a wall window
    The one-piece drum and axle could not be assembled. Now a straight
    19 mm window in the right wall, a drum with a 3.5 mm bore passed in
    edge-first, and a separate 3 mm pin pushed in from the front into a
    press-fit hole in the post. Drum prints flat with no supports.
    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
2026-11-10 Doorstep: fixes from the second test print
    - USB-C hole was half filled by a ledge gusset: tunnel re-cut after
    the supports.
    - Front bowed out with the panel in: whole board mount 0.6 mm deeper
    (0.7 mm gap behind the glass).
    - Pin would not enter the post: hole 2.9 -> 3.2 mm (prints undersize).
    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
2026-11-10 Doorstep: springy drum mount
    Hub missed the wheel by ~0.8 mm and the drum slid on its pin. Axle now
    1.85 mm into the wheel on a boss hung from the top wall by a flexing
    22 x 5 x 1.2 mm arm (preload holds the hub on the wheel, pressing clicks
    the button). Pin has a head and the boss sits behind the drum so it
    cannot slide. Bore 3.3 mm, far end-stop gap 0.05 mm, pin prints
    head-down.
    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
2026-11-10 Doorstep: let the drum spin freely
    Drum dragged on the pin. Bore 3.3 -> 3.6 mm, boss gap 0.3 mm, post hole
    0.5 mm shallower so the pin bottoms out with its head 0.3 mm off the
    drum.
    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
2026-11-10 Latch: O-ring tyre on the hub
    A plain PLA hub only drove the wheel when pressed. The hub now has a
    groove for a 6 x 1 mm NBR O-ring; only the rubber touches the wheel.
    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
2026-11-10 Doorstep: seat and tongue for the front, button press tabs
    - Front bumps lifted the plate at the bottom: replaced by a seat ledge
    2 mm behind the face and a continuous tongue.
    - Wheel-end stops are solid blocks; pillars thicker with gussets.
    - Each button has a press tab reached through one straight 1.6 mm bore.
    - Wheel window smaller (6.3 x 18 mm plus a hub notch).
    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
2026-11-10 Doorstep: lip on the plate, groove in the body
    Lip moved to the plate and a 1 x 1 mm groove cut into the body's seat,
    so a flat acrylic lens can also sit on the seat. Screen window flush
    with the live area. Hub notch is a blind pocket. Plain 10.5 x 7.5 mm
    USB opening, no cable groove. Seat chamfer cleared at the snap arms.
    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
2026-11-10 Latch: bigger drum, 24 mm
    Drum 18 -> 24 mm, 80 knurls, sits 1.4 mm deeper on a longer spacer, so
    it pops out 5.1 mm. Side slot 6.3 x 24.2 mm; wheel-end blocks and tabs
    cleared along the drum's path. Pin 17 mm.
    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
2026-11-10 Doorstep: board lock (edge stops, leaf springs, plate pads)
    After a drop test and USB wiggle: 7 rigid edge stops 0.1 mm off the
    board's long edges, 4 leaf springs in the ledges pushing the board onto
    the corner hooks, and 8 pads on the plate's back. Reconstructed: the
    saved model had the pads already removed.
    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
2026-11-10 Doorstep Slope: remove the plate pads
    The pads printed as tiny first-layer islands and ruined the plate, and
    there is no front-back wiggle without them. Plate prints on its lip
    ring with tree supports.
    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
2026-11-10 Add enclosure/doorstep directory for the Doorstep case
    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
2026-11-10 Doorstep: run from the repo; add docs, test log and print files
    - src/doorstep.py and scripts/ use paths relative to enclosure/doorstep;
    the CrowPanel STEP comes from vendor/ (git-ignored) or CROWPANEL_STEP.
    - README with build steps, CHANGELOG (design notes), REQUIREMENTS from
    test prints, TESTLOG with one line per print.
    - Current models (STEP/STL), print-ready STLs and the X2D 3MF plate,
    assembly guide and preview images. Rebuilt from this tree: identical
    STLs.
    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
    [body.step, body.stl, doorstep_body_white.stl, doorstep_slope_front_white.stl, doorstep_slope_plate.3mf, front_bevel.step, front_bevel.stl, front_lens.step]
2026-11-10 Doorstep: list print commits in the test log
    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
2026-11-10 Doorstep: correct the test log to Adi's four prints
    Prints re-matched using Pacific time; note that the replayed commit
    times are UTC labelled -0700.
    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
2026-11-10 Doorstep: test log lists five prints (print 4 abandoned)
    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
2026-11-10 Doorstep: print 3 reused the print-2 drum; no O-ring drum printed
    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
2026-11-10 Latch: plain PLA hub, drop the O-ring tyre
    Print 3 showed the springy mount makes a plain hub grip and click the
    wheel well. The 24 mm drum now has a plain r 4 hub; plain-drum script
    and STL removed as redundant.
    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
    [body.step, doorstep_slope_plate.3mf, front_bevel.step, front_lens.step, latch_drum_orange.stl, latch_drum_orange_plain.stl, latch_pin.step, orange_wheel_cap.step]
2026-11-10 Doorstep: keep only STEP in models/; STLs live in print-ready
    So every STL change is a single print-ready file, one per commit.
    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
    [body.stl, front_bevel.stl, front_lens.stl, latch_pin.stl, orange_wheel_cap.stl]
2026-11-10 stl: body-1 (corner snap arms)
    From model commit d515d98. Printed in P1.
    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
    [doorstep_body_white.stl]
2026-11-10 stl: front-1 (Slope, 4 ridges 0.25 mm)
    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
    [doorstep_slope_front_white.stl]
2026-11-10 stl: drum-1 (18 mm, one piece with axle)
    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
    [latch_drum_orange.stl]
2026-11-10 stl: body-2 (ledges, end stops, wall window)
    From model commit f99f9fc. Printed in P2.
    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
    [doorstep_body_white.stl]
2026-11-10 stl: front-2 (ridges 0.45 mm, 6 ridges)
    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
    [doorstep_slope_front_white.stl]
2026-11-10 stl: drum-2 (18 mm, 3.5 mm bore, separate pin)
    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
    [latch_drum_orange.stl]
2026-11-10 stl: pin-1 (3 mm, plain)
    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
    [latch_pin_orange.stl]
2026-11-10 stl: body-3 (springy drum mount, USB re-cut, mount 0.6 mm deeper)
    From model commit d340d7d. Printed in P3.
    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
    [doorstep_body_white.stl]
2026-11-10 stl: body-4 (seat + groove, press tabs, board lock)
    From model commit 23641a8 (unchanged at 1c2e20c). On the P4 and P5 plates.
    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
    [doorstep_body_white.stl]
2026-11-10 stl: front-3 (lip, flush window, back pads)
    From model commit 23641a8. P4, abandoned: the pads ruined the print.
    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
    [doorstep_slope_front_white.stl]
2026-11-10 stl: front-4 (lip, flush window, no pads)
    From model commit 1c2e20c. On the P5 plate.
    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
    [doorstep_slope_front_white.stl]
2026-11-10 stl: pin-2 (3 mm, 4 mm head, 17 mm)
    From model commit 1c2e20c. On the P4/P5 plates.
    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
    [latch_pin_orange.stl]
2026-11-10 stl: drum-3 (24 mm, plain hub)
    From model commit 166a22b. Not printed yet. The 24 mm O-ring drum on the
    P4/P5 plates was never printed, so it gets no number.
    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
    [latch_drum_orange.stl]
2026-11-10 Doorstep: part revisions, print log and assembly log
    Replace TESTLOG with parts.md (body-N, front-N, drum-N, pin-N and their
    commits), prints/P01-P05 and assemblies/A01-A03, and write the commit
    conventions into the README.
    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
2026-11-10 Doorstep: drum-3 was printed in P5
    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
2026-11-10 Add enclosure/DEVELOPMENT.md: how cases are versioned, printed and logged
    Moves the Doorstep conventions there (part revisions, stl: commits,
    renders, print and assembly logs, photos and videos) so every case
    follows the same rules.
    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
2026-11-11 Doorstep P5 log: front-4 print notes
    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
2026-11-11 Doorstep: A4 assembly notes and photos (P5 parts)
    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
2026-11-11 Doorstep logs: print log is parts + settings only; A5 (front-2 on body-4)
    All feedback, including print quality and photos, now lives in the
    assembly log. Front-4 photos moved to A4; DEVELOPMENT.md updated.
    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
2026-11-12 Doorstep-back: first model (one-piece bevelled front, board loads from the back, snap-on back cap)
    New case folder next to Doorstep. Same outside and drum; the front is part of the
    body, the board clicks in from behind onto front pads, and a full back cap with
    lips and 4 snap tabs closes it. Fit checks clean.
    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
    [back_cap.step, body.step, drum.step, pin.step]
2026-11-12 stl: body-1 (One piece with a bevelled front; board loads from the back onto front pads, 4 snap arms)
    From model commit 5a48217 (Doorstep-back first model).
    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
    [doorstep_back_body_white.stl]
2026-11-12 stl: cap-1 (Full back cap, locating lips, 4 snap tabs)
    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
    [doorstep_back_cap_white.stl]
2026-11-12 stl: drum-1 (24 mm, plain hub (same shape as Doorstep drum-3))
    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
    [latch_drum_orange.stl]
2026-11-12 stl: pin-1 (3 mm, 4 mm head at the back, goes in from behind)
    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
    [latch_pin_orange.stl]
2026-11-12 Doorstep-back: 3MF bed with all four parts; parts.md commit hashes
    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
    [doorstep_back_bed.3mf]
